jmharvey1/DDS_AD9850_AntennaAnalyzer/README.md

# DDS_AD9850_AntennaAnalyzer
This is a no frills DIY Analyzer intended for frequencies ranging from 1.6 to 30 Mhz
See http://youtu.be/C6YxD72sX_Y for a description of this project
