jmharvey1/DDS_AD9850_AntennaAnalyzer/Eagle Files/Antenna Analyzer R1 Schematic.pdf

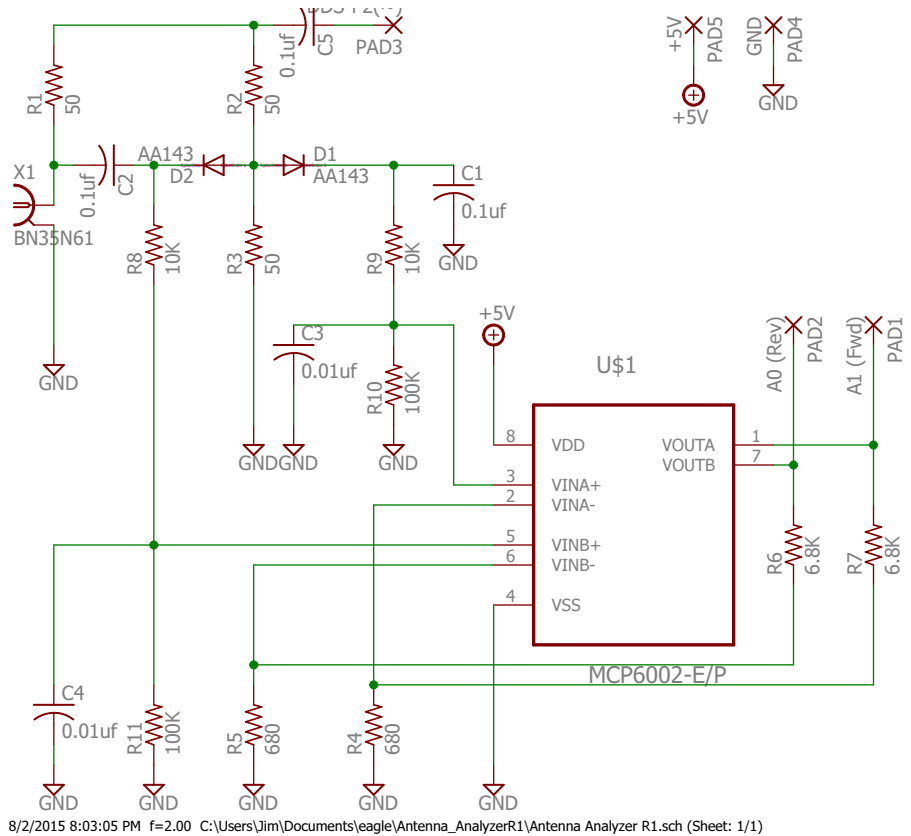
[picture p1: page 1]

8/2/2015 8:03:05 PM f=2.00 C:\Users\Jim\Documents\eagle\Antenna_AnalyzerR1\Antenna Analyzer R1.sch (Sheet: 1/1)

DDS-P2(~)
