jmharvey1/DDS_AD9850_AntennaAnalyzer/Eagle Files/Antenna Analyzer R1 Board Layout.pdf

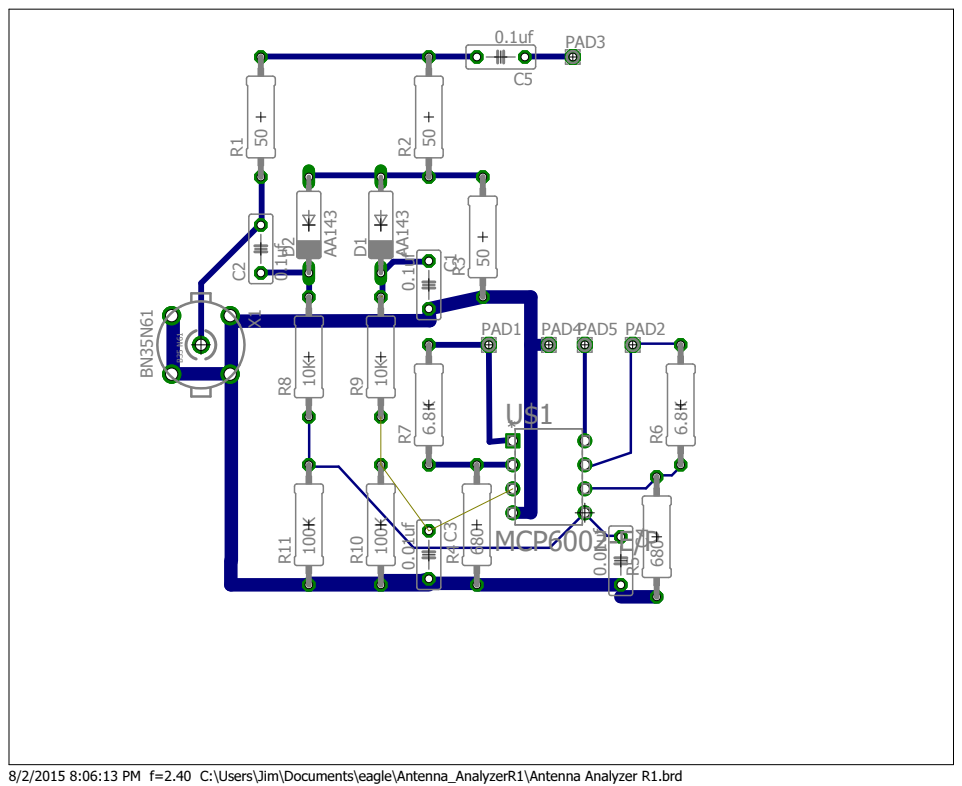
[picture p2: page 1]

8/2/2015 8:06:13 PM f=2.40 C:\Users\Jim\Documents\eagle\Antenna_AnalyzerR1\Antenna Analyzer R1.brd
