jmharvey1/DDS_AD9850_AntennaAnalyzer/Eagle Files/Antenna_AnalyzerR1/Antenna Analyzer R1.brd

## EAGLE design Eagle Files/Antenna_AnalyzerR1/Antenna Analyzer R1.brd (2015-08-03)

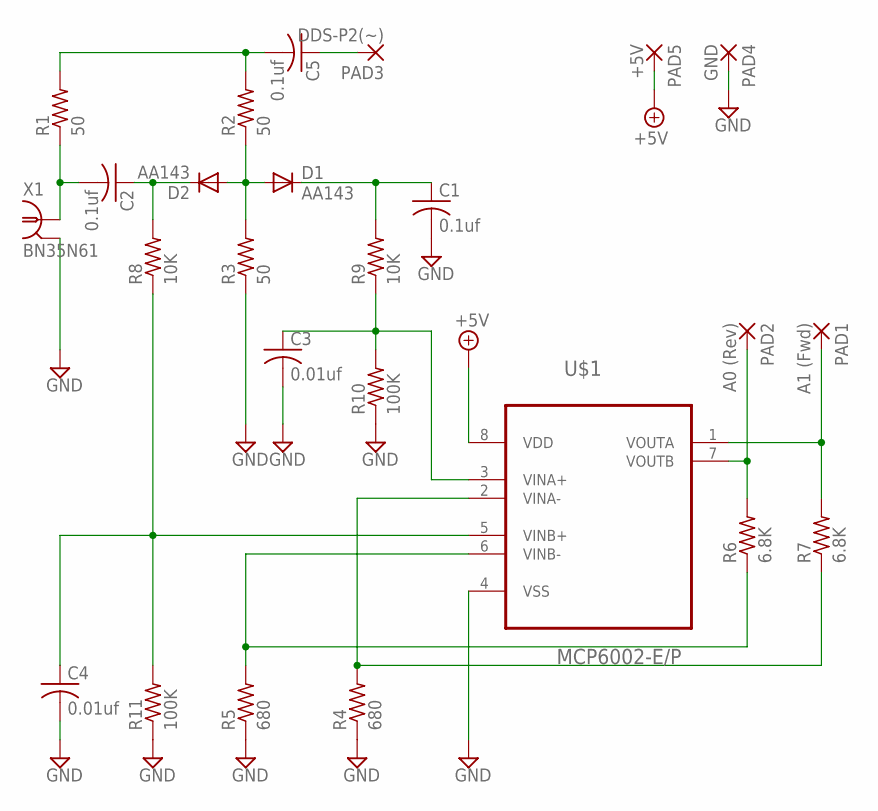
[picture p3: schematic Antenna Analyzer R1.sch]

Parts:
C1, C2, C5: 0.1uf; C050-025X075
C3, C4: 0.01uf; C050-025X075
D1, D2: AA143; DO07
PAD1: A1 (Fwd); 1,6/0,8
PAD2: A0 (Rev); 1,6/0,8
PAD3: DDS-P2(~); 1,6/0,8
PAD4: GND; 1,6/0,8
PAD5: +5V; 1,6/0,8
R1, R2, R3: 50; 0309/12
R4, R5: 680; 0309/12
R6, R7: 6.8K; 0309/12
R8, R9: 10K; 0309/12
R10, R11: 100K; 0309/12
U$1: MCP6002-E/P; DIP254P762X533-8
X1: BN35N61; B35N61

Connections:
+5V: PAD5.1, U$1.8 (VDD)
GND: C1.2, C3.2, C4.2, PAD4.1, R3.1, R4.1, R5.1, R10.1, R11.1, U$1.4 (VSS), X1.2, X1.3 (2), X1.4 (2), X1.5 (2)
unnamed: D1.A, D2.A, R2.1, R3.2
unnamed: C2.2, R1.1, X1.1
unnamed: C2.1, D2.C, R8.2
unnamed: C1.1, D1.C, R9.2
unnamed: C3.1, R9.1, R10.2, U$1.3 (VINA+)
unnamed: C5.2, R1.2, R2.2
unnamed: PAD2.1, R6.2, U$1.7 (VOUTB)
unnamed: PAD1.1, R7.2, U$1.1 (VOUTA)
unnamed: R5.2, R6.1, U$1.6 (VINB-)
unnamed: C4.1, R8.1, R11.2, U$1.5 (VINB+)
unnamed: R4.2, R7.1, U$1.2 (VINA-)
unnamed: C5.1, PAD3.1

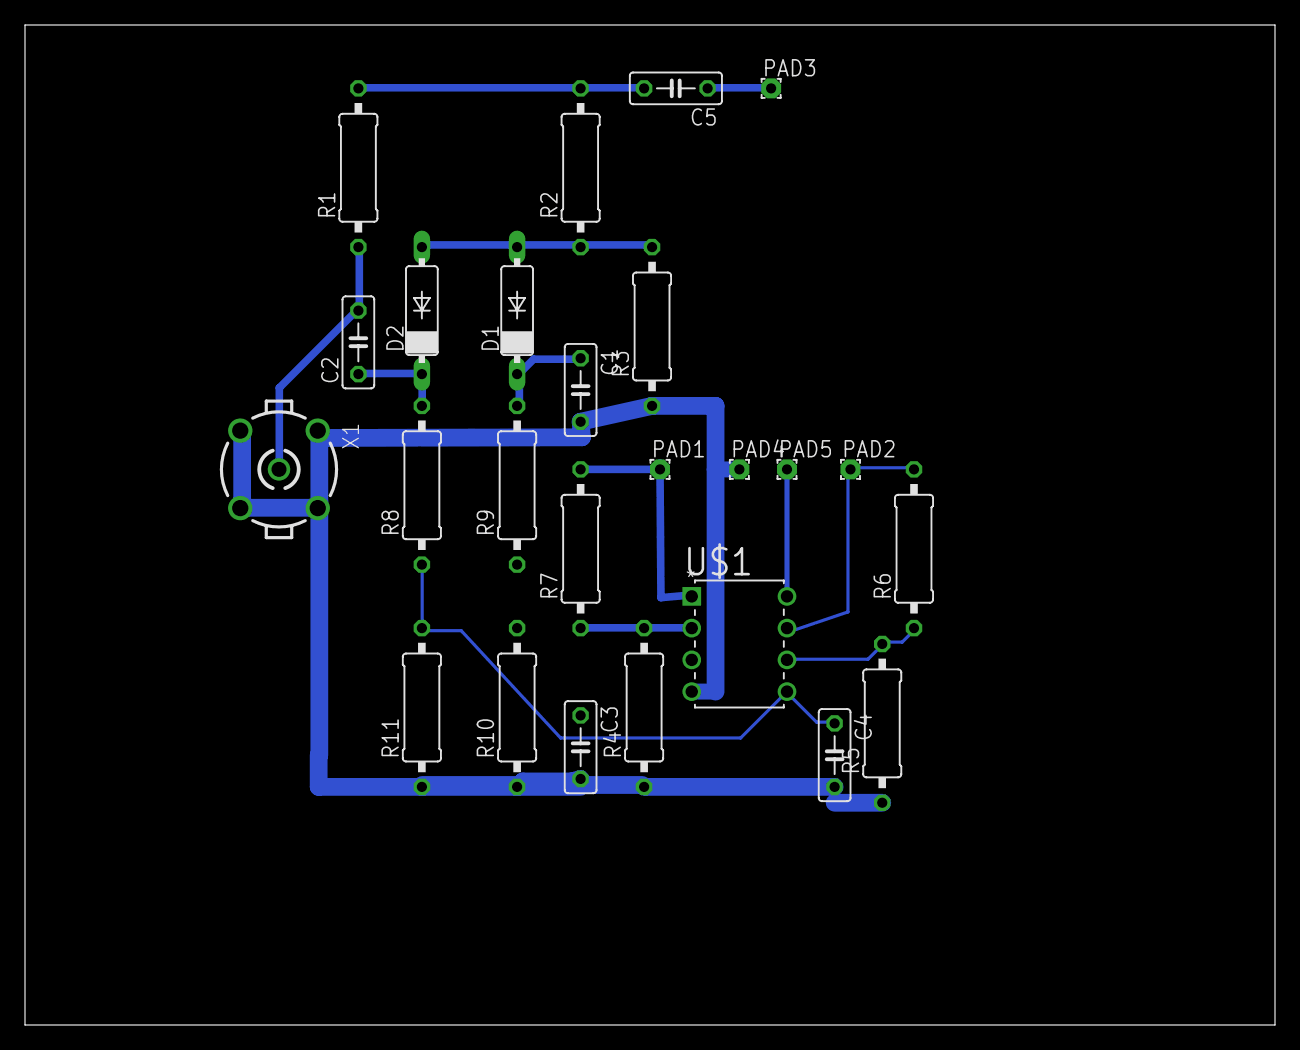
[picture p4: board Antenna Analyzer R1.brd from above]

Board: 2 copper layers, 100.0 x 80.0 mm, 25 parts (0 on the bottom side), 14 nets.
