jmharvey1/DDS_AD9850_AntennaAnalyzer/(commit log)

2015-08-03 This is the initial entry for this respository
    [Antenna Analyzer R1.brd, Antenna Analyzer R1.sch]
2015-09-13 Added 3rd Sketch that supports the addition of a KY040 Rotory Switch to select the Band sweep
2015-10-14 Added code to detect which Arduino board is in play (Uno/Leonardo) at compile time and select the appropriate interrupt vector. Also tweaked ISR routine in an attempt to further reduce the effects en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
2016-04-11 Added Arduino sketch pskmeter an windows application pskscope plus pskscope source code to DIY antenna analyzer project
2016-04-18 Revised Power & voltage scaling computations to include simple constant carrier signal
2016-04-20 Updated both PSKmeter and PSKscope files to support Arduino's 10-bit A-to-D output. Previous releases degraded the data exchange to 8-bit data. Other minor changes were made related scaling and repor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
2020-05-16 Added Arduino to support Fixed Frequency Testing
    [Ant_Analyzer_w_128x64DisplayPlusKY040RotoryEncoder_R1.ino]
